MathisRosenhauer/THR_Footswitch/images/footswitch_bb.png

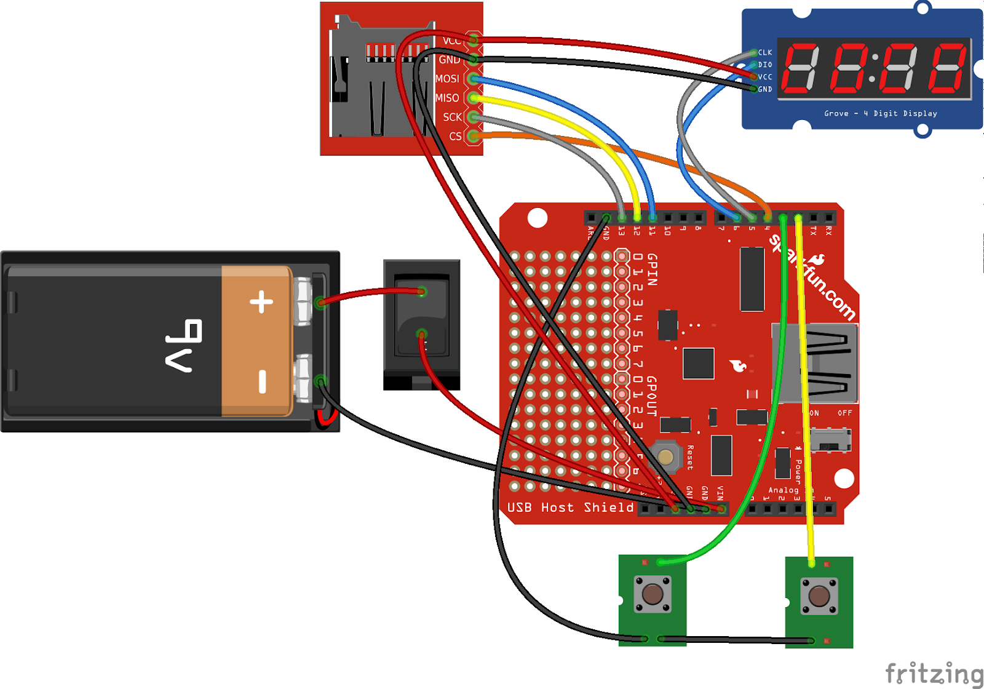
images/footswitch_bb.png
