MathisRosenhauer/THR_Footswitch/patches.h

/*
  Two simple patches using the first and the second amp
  simulation. They were created on a THR10C but should work on any
  THR10.
 */
const uint8_t patches[] PROGMEM = {
0x44,
0x54,
0x41,
0x42,
0x30,
0x31,
0x64,
0x00,
0x00,
0x00,
0x00,
0x00,
0x00,
0x6d,
0x6f,
0x64,
0x65,
0x6c,
0x31,
0x00,
0x00,
0x00,
0x00,
0x00,
0x00,
0x00,
0x00,
0x00,
0x00,
0x00,
0x00,
0x00,
0x00,
0x00,
0x00,
0x00,
0x00,
0x00,
0x00,
0x00,
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
};
