MathisRosenhauer/THR_Footswitch/(commit log)

2015-08-22 Simple arduino sketch to upload patches to THR10c.
2015-10-24 Send current patch once THR10 is connected.
2015-11-02 Two pictures of current set-up.
2015-11-03 Reduce memory footprint.
2018-05-12 Add sample patches.h for testing
