MathisRosenhauer/THR_Footswitch/(notices)

Notices in the files:
THR_Footswitch.ino:
modify it under the terms of the GNU General Public License
